StevenKnudsen/tensile-tester-flow/README.md

tensile-tester-flow
===================

Node-Red project for the Hussein Lab Tensile Tester

### About
