StevenKnudsen/tensile-tester-flow/docs/images/dimension-engineering-syren20.png

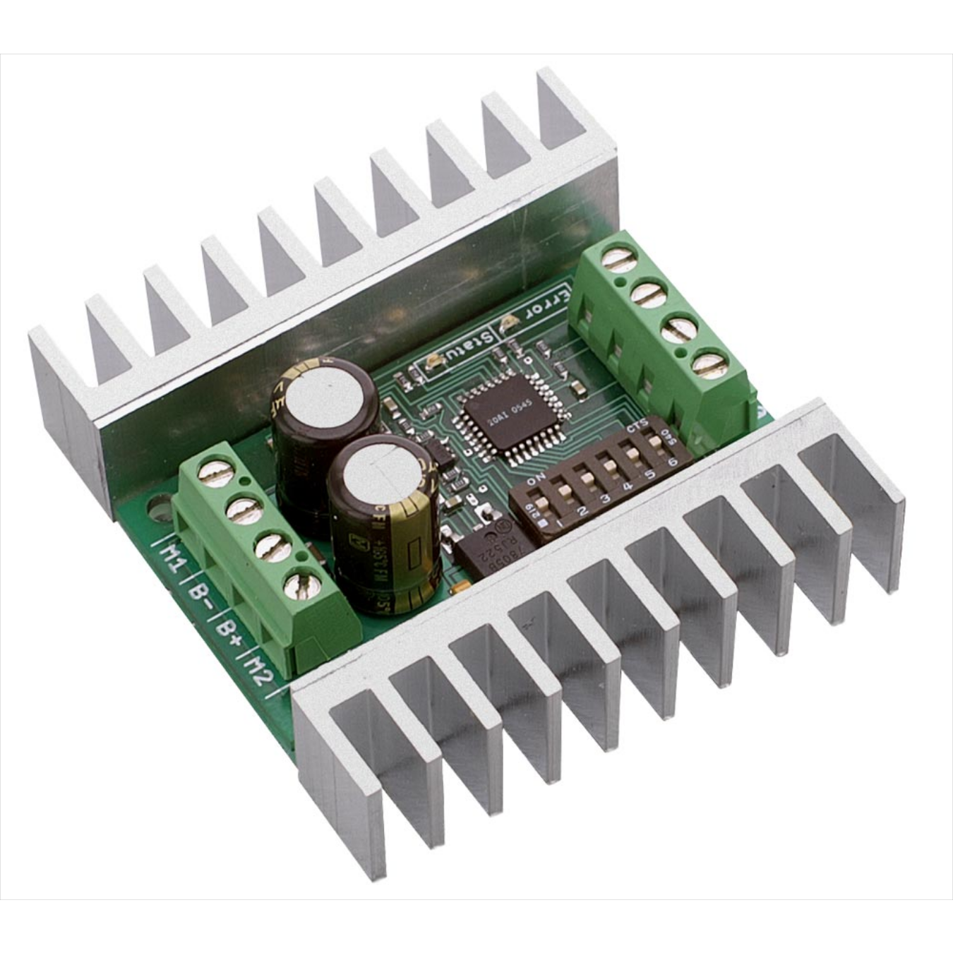
docs/images/dimension-engineering-syren20.png
