StevenKnudsen/tensile-tester-flow/docs/images/HeadStockStepperConnector.png

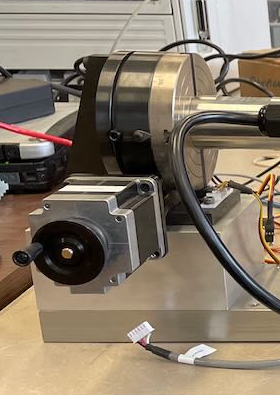
docs/images/HeadStockStepperConnector.png
