StevenKnudsen/tensile-tester-flow/docs/images/ImprovedLinearActuatorAdapter.jpeg

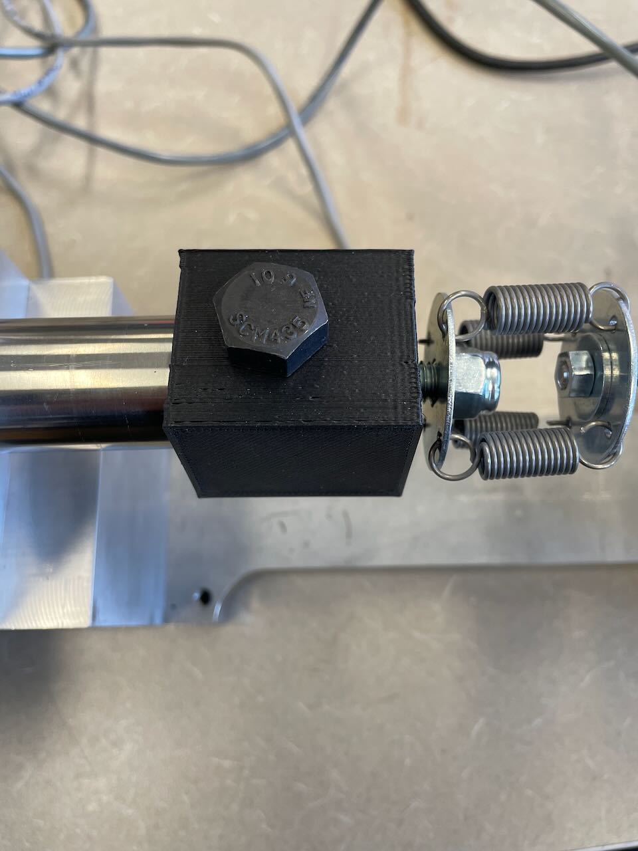
docs/images/ImprovedLinearActuatorAdapter.jpeg
