StevenKnudsen/tensile-tester-flow/docs/images/LinearActuatorConnector.png

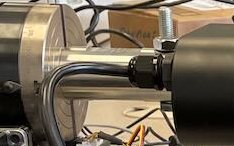
docs/images/LinearActuatorConnector.png
