StevenKnudsen/tensile-tester-flow/docs/images/LinearActuatorDriverConnections01.jpeg

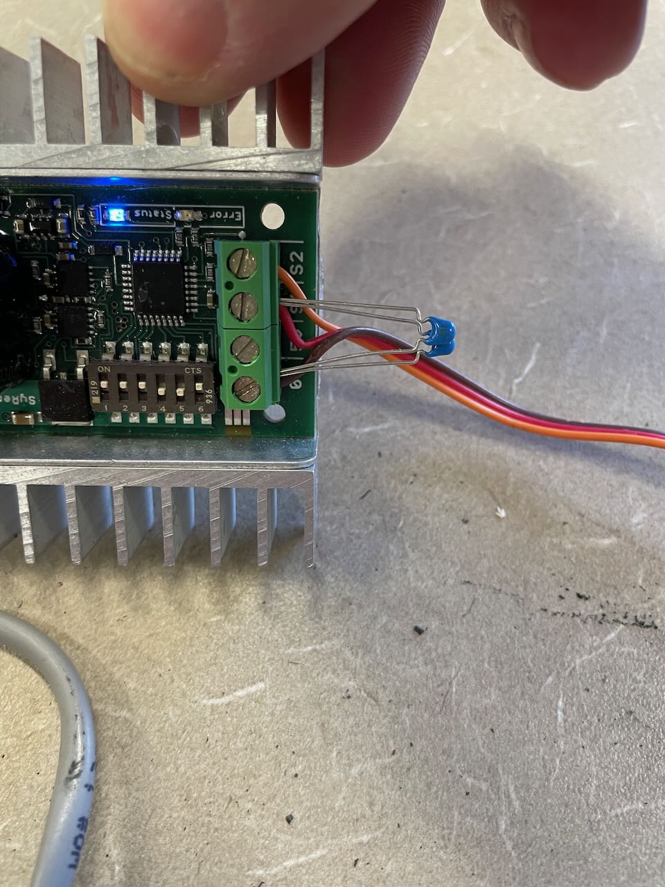
docs/images/LinearActuatorDriverConnections01.jpeg
