StevenKnudsen/tensile-tester-flow/docs/images/LoadCell01.jpg

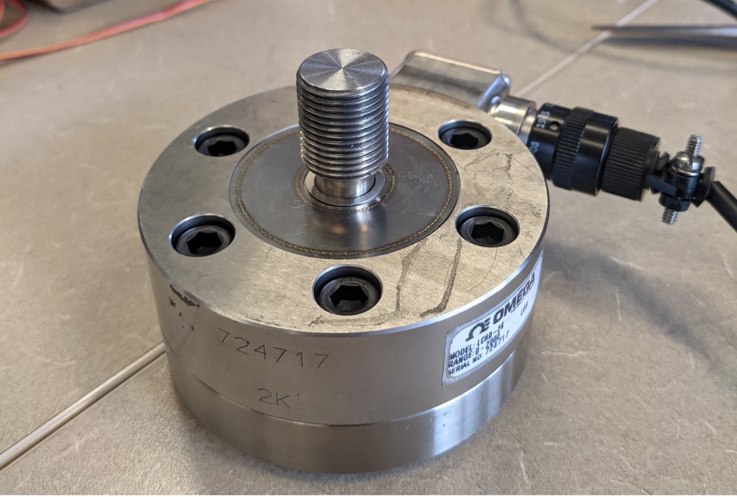
docs/images/LoadCell01.jpg
