StevenKnudsen/tensile-tester-flow/docs/images/LoadCellCal01.jpeg

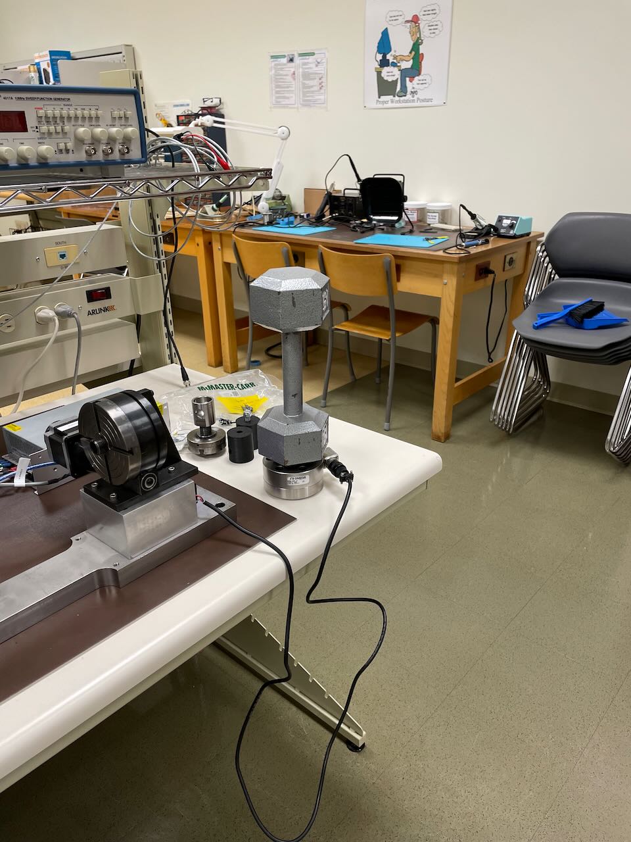
docs/images/LoadCellCal01.jpeg
