StevenKnudsen/tensile-tester-flow/docs/images/OpenScaleBoard.jpeg

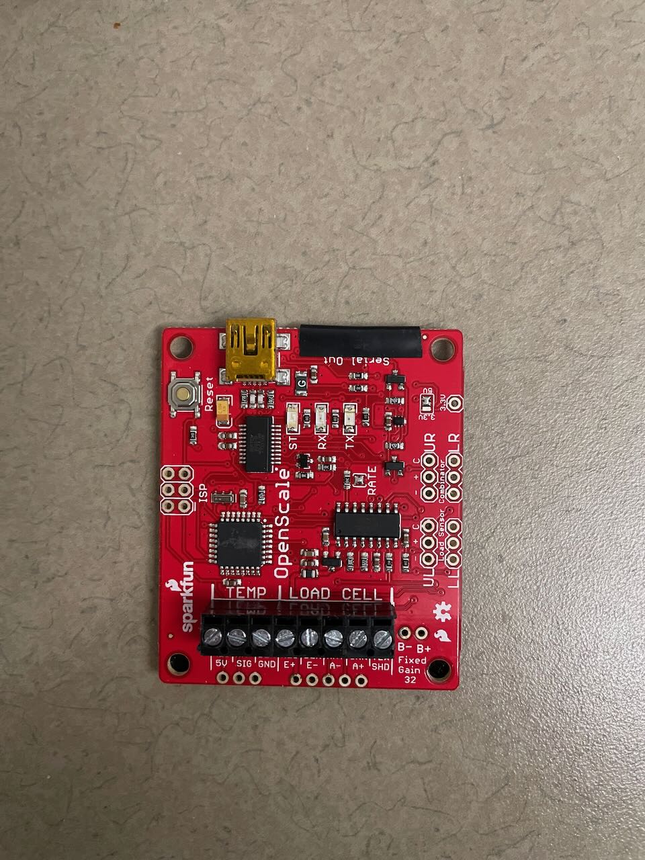
docs/images/OpenScaleBoard.jpeg
