StevenKnudsen/tensile-tester-flow/docs/images/RPI_w_Ribbon.jpeg

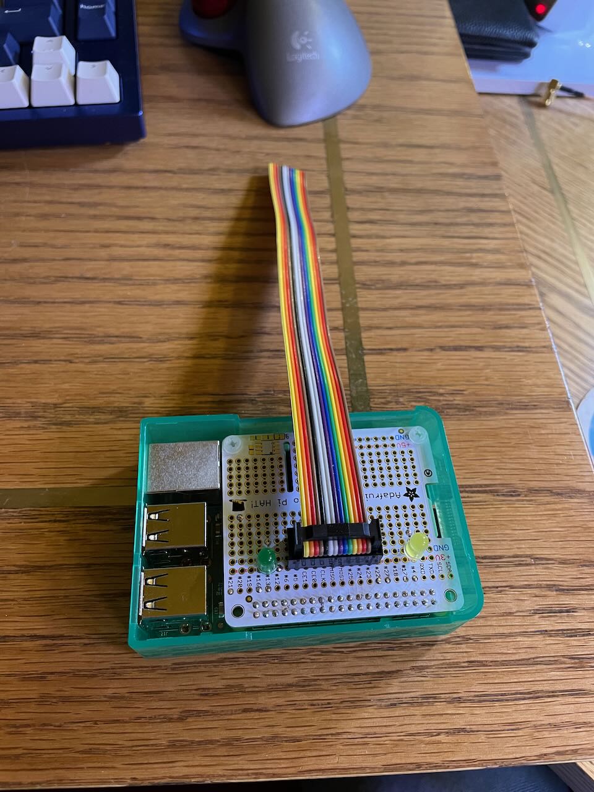
docs/images/RPI_w_Ribbon.jpeg
