StevenKnudsen/tensile-tester-flow/docs/images/SpringConfig01.jpeg

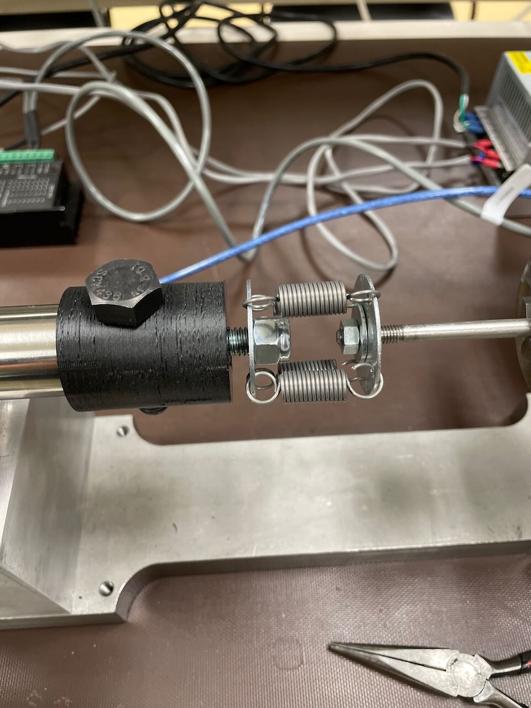
docs/images/SpringConfig01.jpeg
