StevenKnudsen/tensile-tester-flow/docs/images/SpringConfig02.jpeg

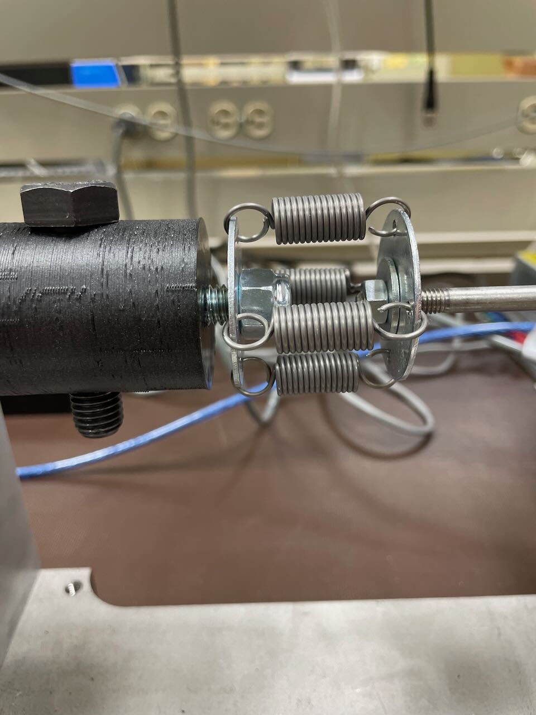
docs/images/SpringConfig02.jpeg
