StevenKnudsen/tensile-tester-flow/docs/images/SpringConfig03.jpeg

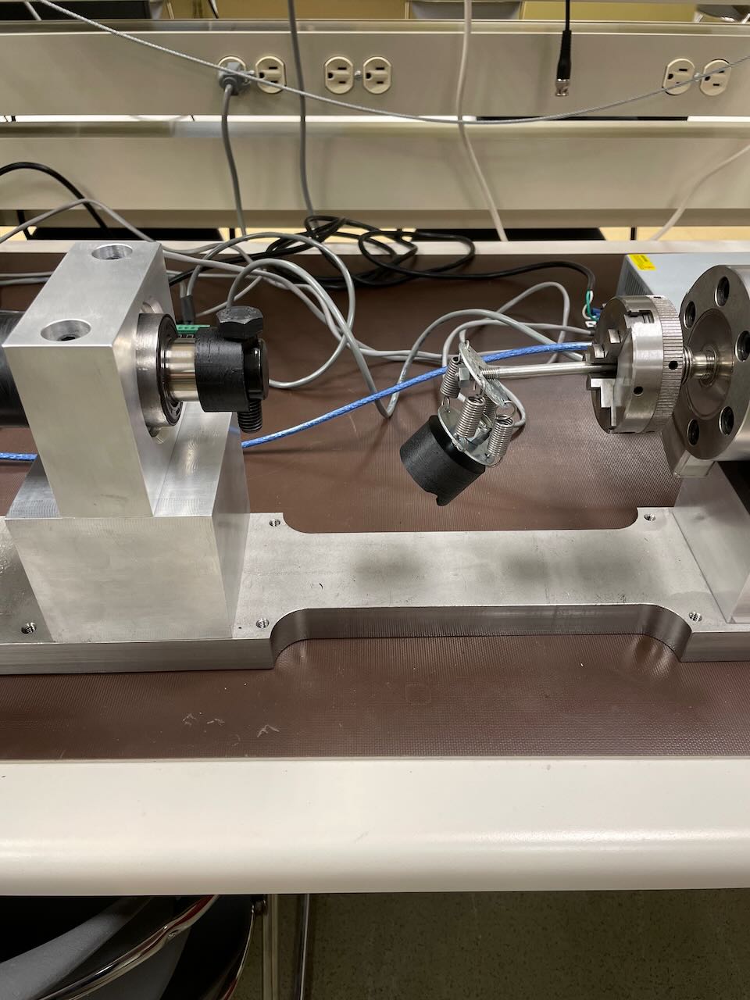
docs/images/SpringConfig03.jpeg
