StevenKnudsen/tensile-tester-flow/docs/images/Startup_Seq.drawio.png

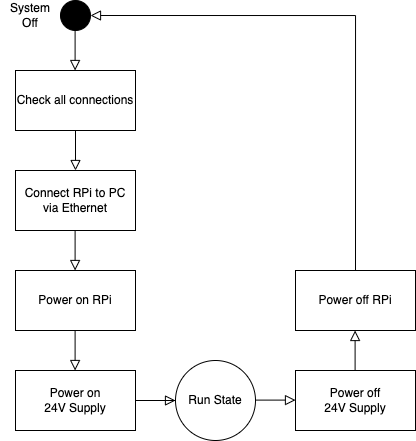
docs/images/Startup_Seq.drawio.png
