StevenKnudsen/tensile-tester-flow/docs/images/StepperDriverConnection01.jpeg

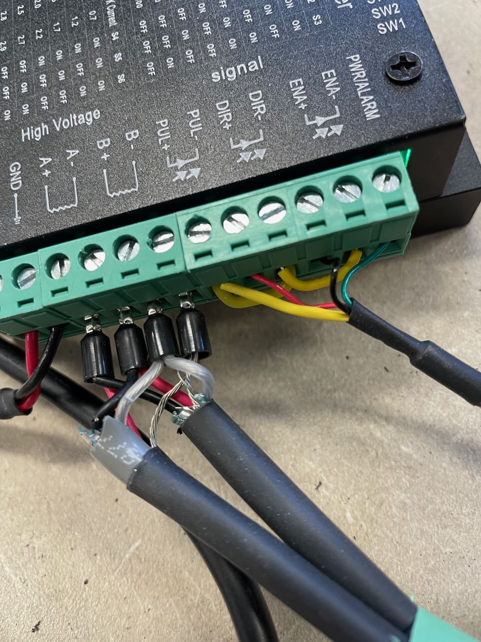
docs/images/StepperDriverConnection01.jpeg
