StevenKnudsen/tensile-tester-flow/docs/images/StepperDriverConnection02.jpeg

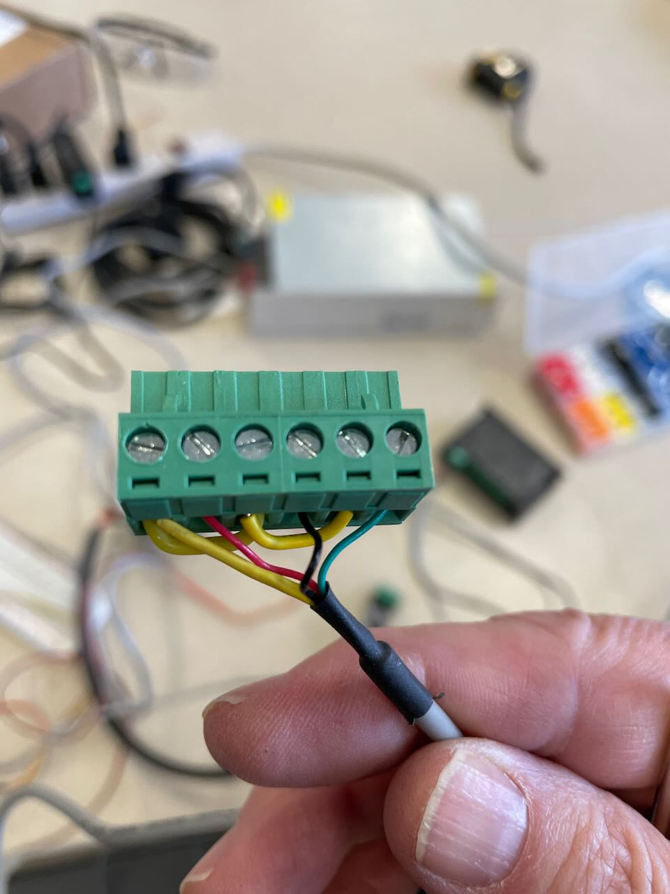
docs/images/StepperDriverConnection02.jpeg
