StevenKnudsen/tensile-tester-flow/docs/images/StepperDriverConnection03.jpeg

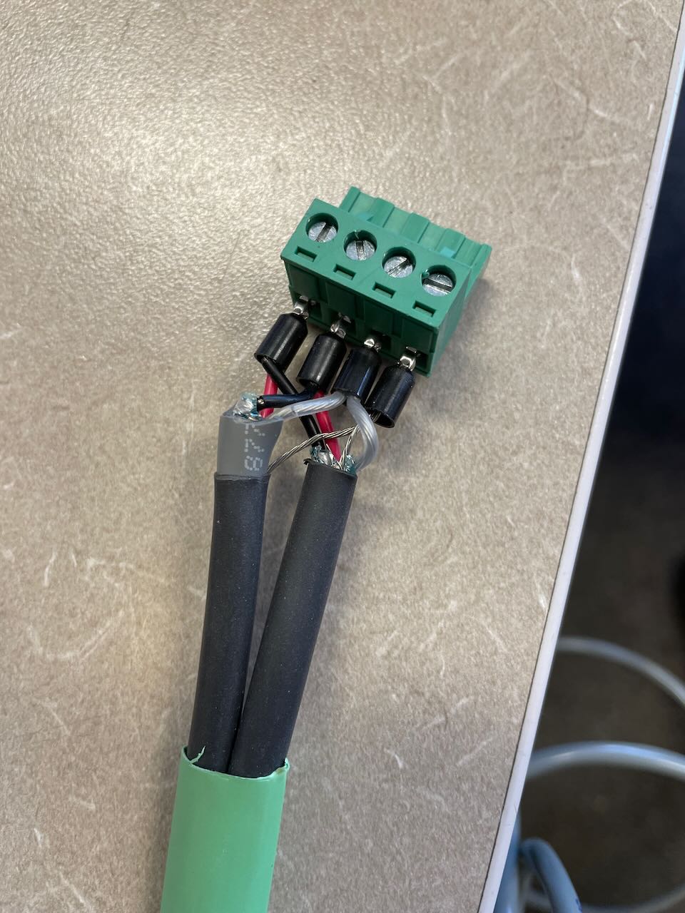
docs/images/StepperDriverConnection03.jpeg
