StevenKnudsen/tensile-tester-flow/docs/images/StopSwitch01.jpg

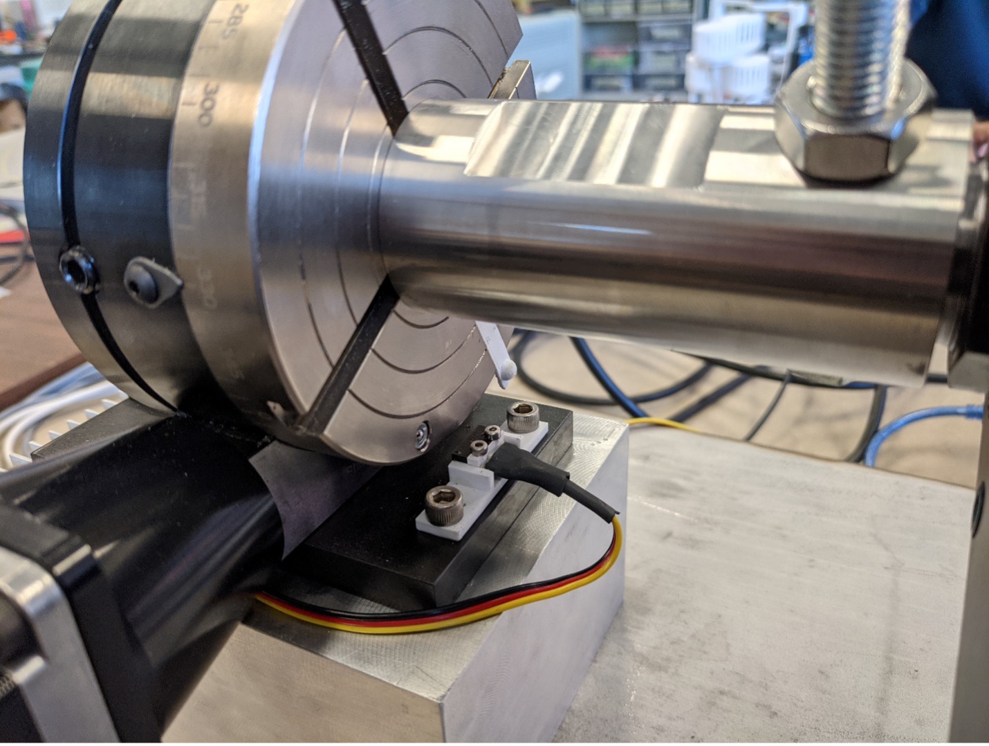
docs/images/StopSwitch01.jpg
