StevenKnudsen/tensile-tester-flow/docs/images/TailStockWithChuck.jpg

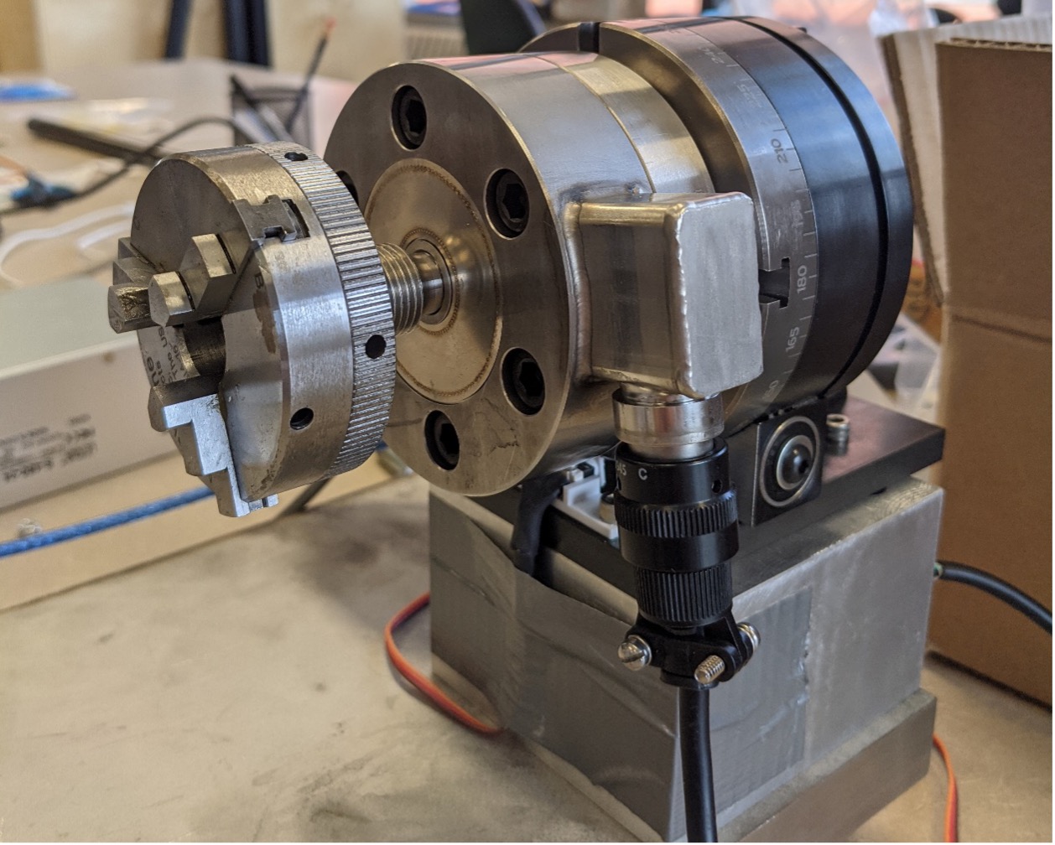
docs/images/TailStockWithChuck.jpg
