StevenKnudsen/tensile-tester-flow/docs/images/tb6600-stepper-motor-driver.jpg

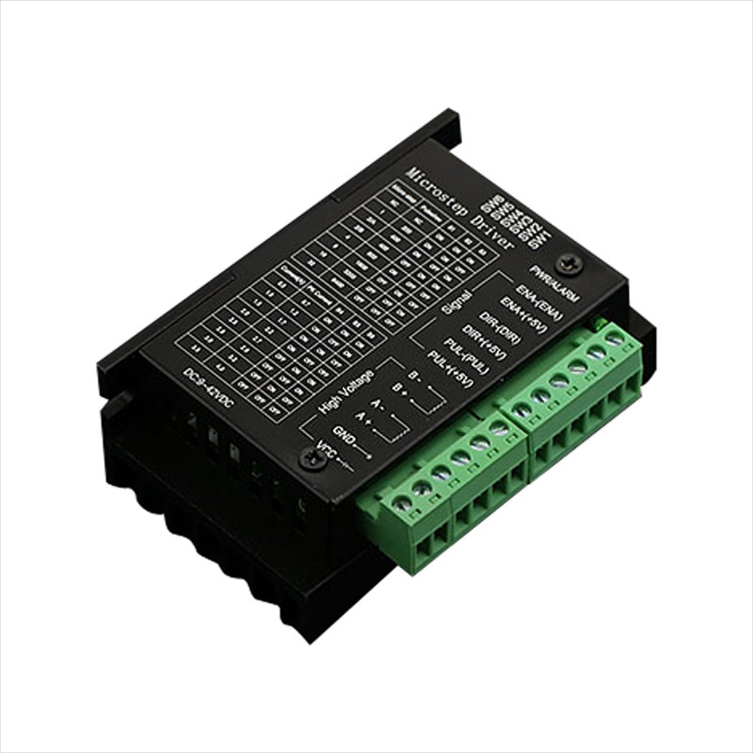
docs/images/tb6600-stepper-motor-driver.jpg
