StevenKnudsen/tensile-tester-flow/docs/images/TTFinalConfig.jpeg

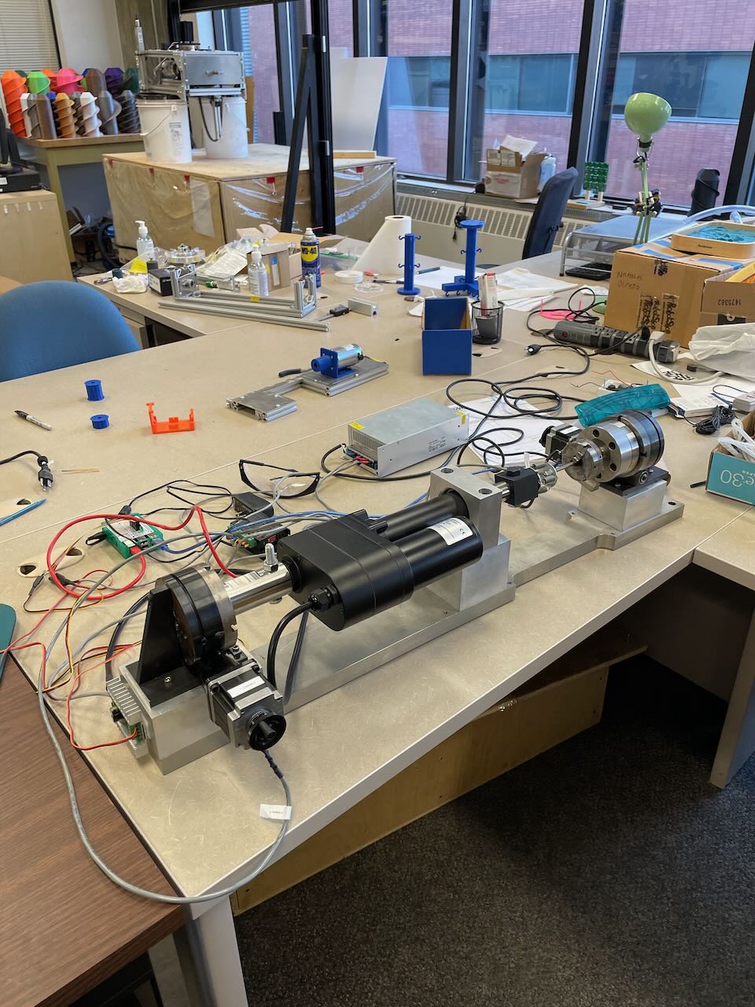
docs/images/TTFinalConfig.jpeg
