StevenKnudsen/tensile-tester-flow/docs/images/TTNoChuckOrGauge.jpeg

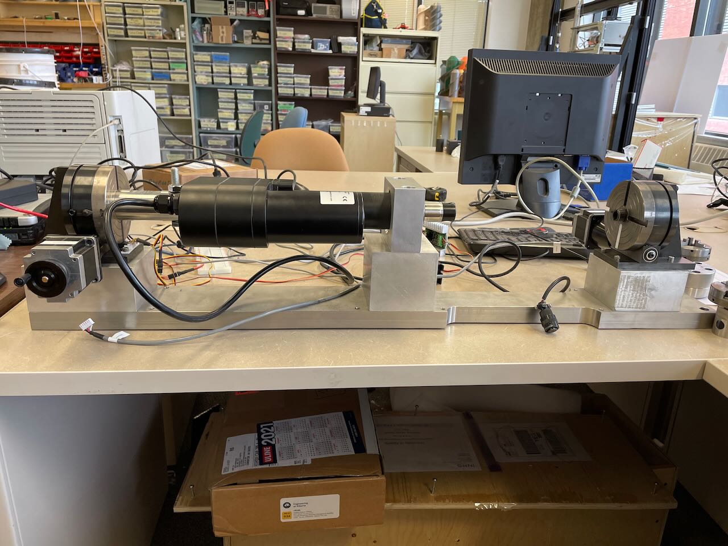
docs/images/TTNoChuckOrGauge.jpeg
