StevenKnudsen/tensile-tester-flow/docs/images/ZeroStop01.jpeg

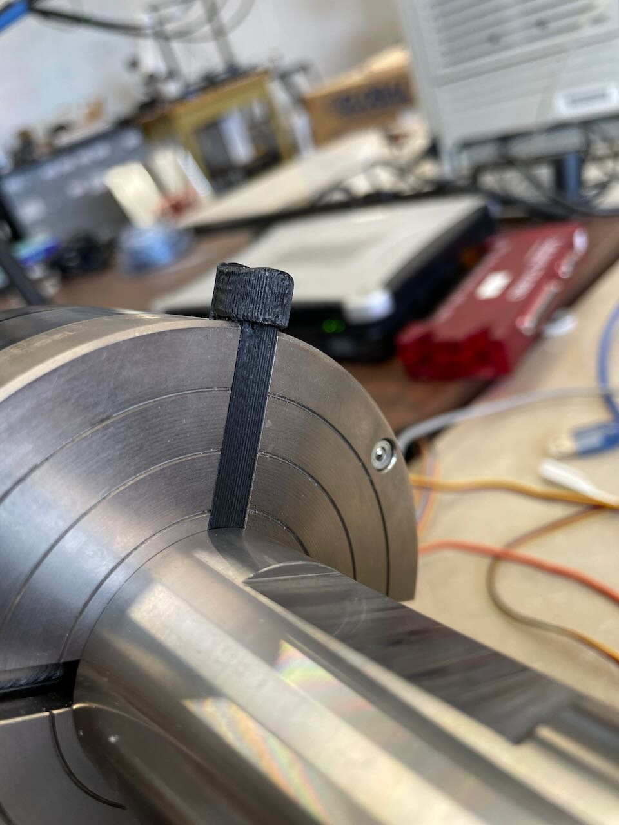
docs/images/ZeroStop01.jpeg
