StevenKnudsen/tensile-tester-flow/docs/images/ZeroStop02.jpeg

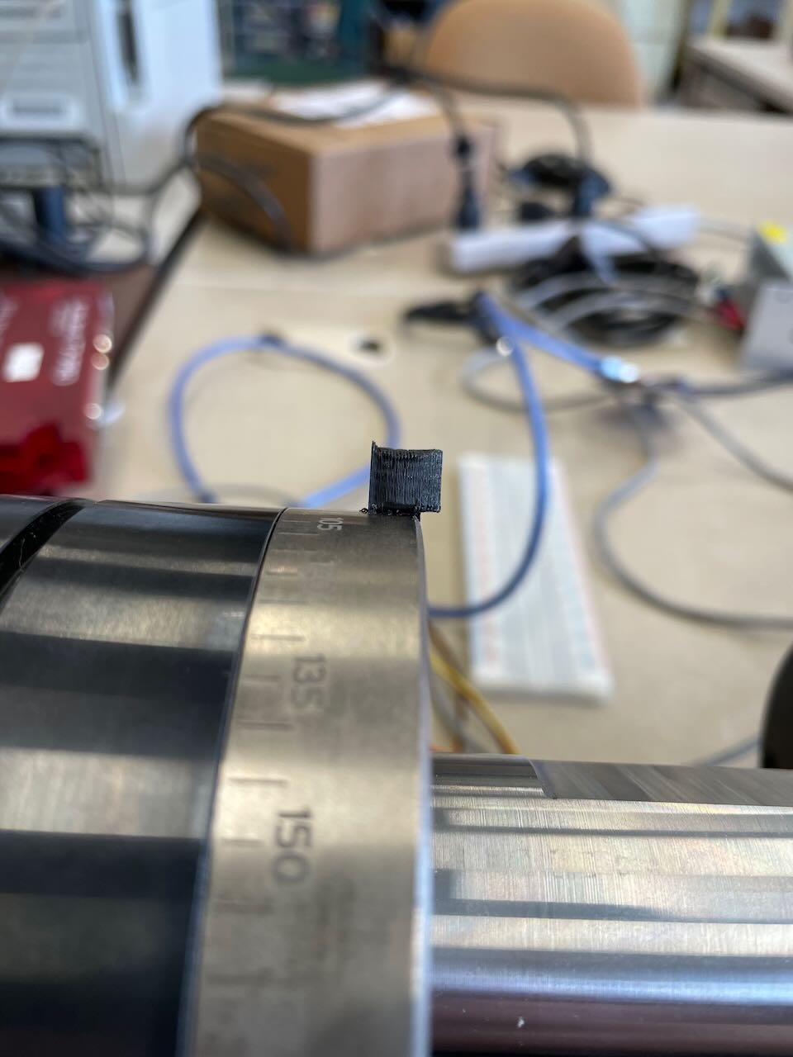
docs/images/ZeroStop02.jpeg
