StevenKnudsen/tensile-tester-flow/mechanical/Zero Position Actuator Design/ZeroPositionActuator.stl

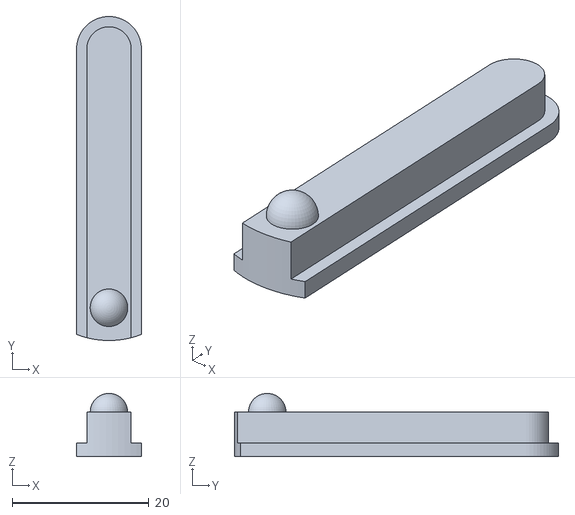
[picture p27: CAD file, 2022-10-16]
mechanical/Zero Position Actuator Design/ZeroPositionActuator.stl
9.50 x 47.4 x 9.25
