StevenKnudsen/tensile-tester-flow/mechanical/Zero Position Actuator Design/ZeroPositionActuatorV.stl

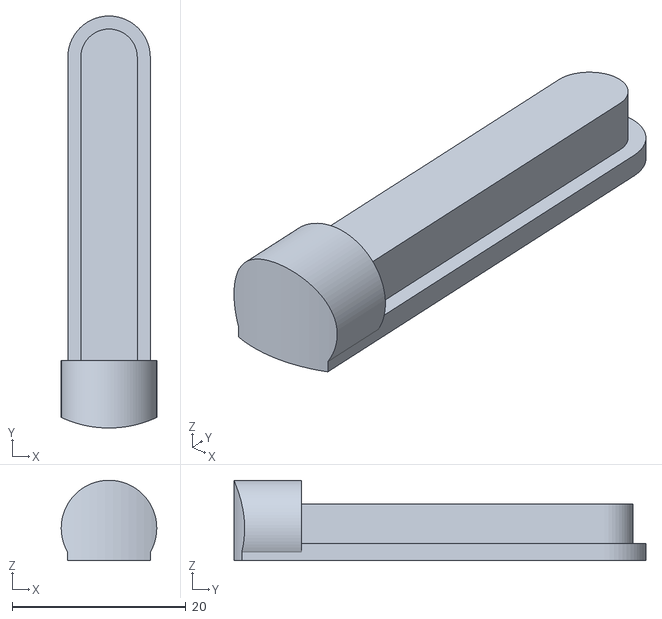
[picture p28: CAD file, 2022-10-16]
mechanical/Zero Position Actuator Design/ZeroPositionActuatorV.stl
11.0 x 47.4 x 9.25
