StevenKnudsen/tensile-tester-flow/mechanical/LinearActuatorAdapters/SpringMountActuatorCap_Carriage.stl

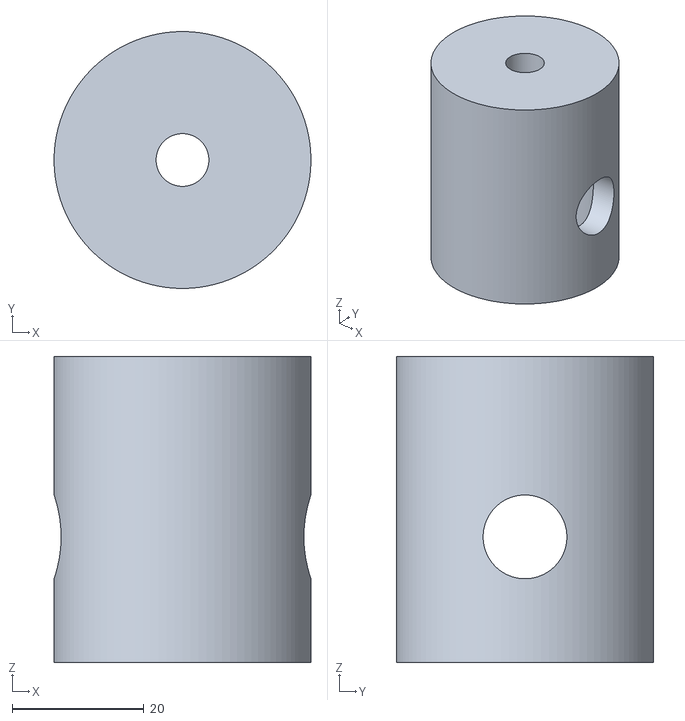
[picture p29: CAD file, 2022-10-14]
mechanical/LinearActuatorAdapters/SpringMountActuatorCap_Carriage.stl
39.0 x 39.0 x 46.4
