StevenKnudsen/tensile-tester-flow/mechanical/LinearActuatorAdapters/SpringMountActuatorCap_BoltCube.stl

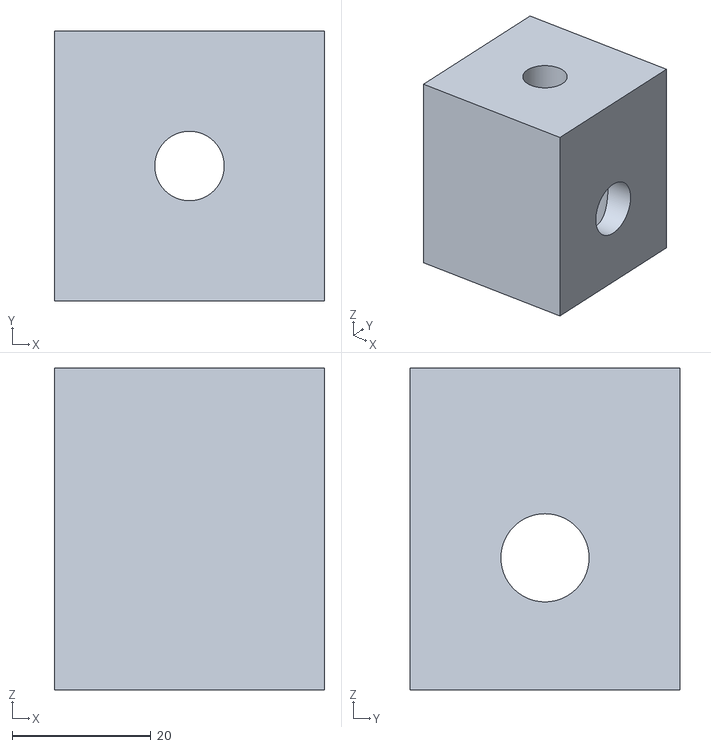
[picture p30: CAD file, 2022-10-14]
mechanical/LinearActuatorAdapters/SpringMountActuatorCap_BoltCube.stl
39.0 x 39.0 x 46.4
