StevenKnudsen/tensile-tester-flow/mechanical/archive/ZeroStop/switch v6 v1.stl

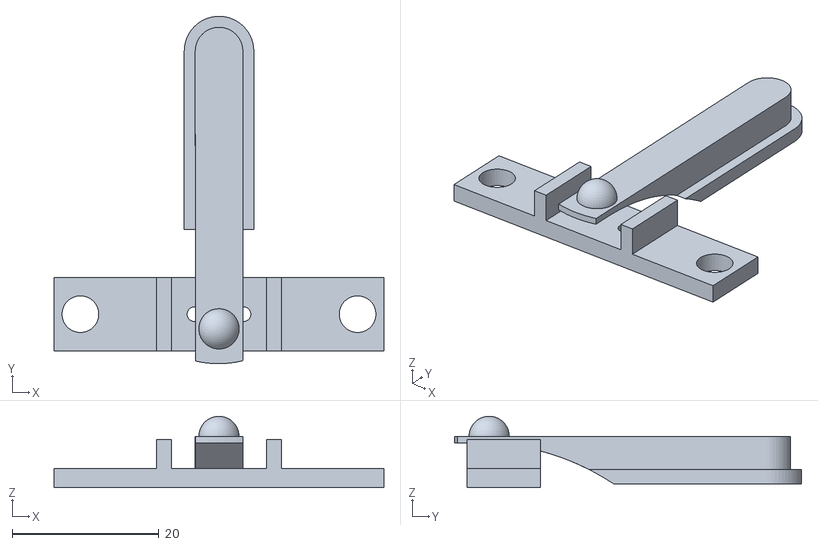
[picture p31: CAD file, 2022-10-16, an earlier design]
mechanical/archive/ZeroStop/switch v6 v1.stl
45.0 x 47.4 x 9.75
