StevenKnudsen/tensile-tester-flow/mechanical/archive/ZeroStop/switch v6 v1a.stl

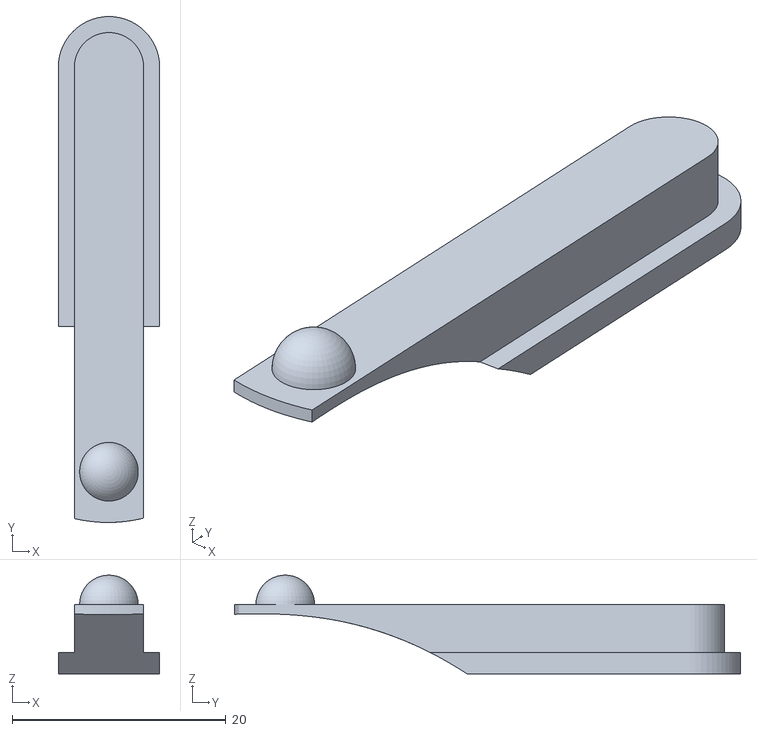
[picture p32: CAD file, 2022-10-16, an earlier design]
mechanical/archive/ZeroStop/switch v6 v1a.stl
9.50 x 47.4 x 9.25
