StevenKnudsen/tensile-tester-flow/mechanical/archive/ZeroStop/mount.stl

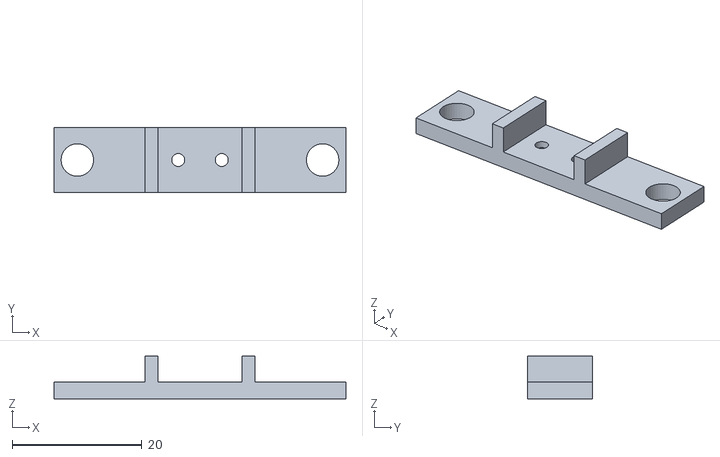
[picture p33: CAD file, 2022-10-14, an earlier design]
mechanical/archive/ZeroStop/mount.stl
45.0 x 10.0 x 6.60
