StevenKnudsen/tensile-tester-flow/(list of files, cad)

Other CAD files:
mechanical/LinearActuatorAdapters/SpringMountActuatorCap_Bolt.stl
mechanical/archive/ZeroStop/switch v6.step
mechanical/archive/ZeroStop/springswitch.stl
mechanical/LinearActuatorAdapters/SpringMountActuatorCap_BoltCube.scad
mechanical/LinearActuatorAdapters/SpringMountActuatorCap_Carriage.scad
mechanical/Zero Position Actuator Design/ZeroPositionActuatorV.scad
