StevenKnudsen/tensile-tester-flow/docs/TensileTester RPi Setup.pdf

# Setting up Raspberry Pi for Tensile Tester operation

OS version : raspios bullseye

Follow the usual steps (https://www.raspberrypi.com/software/) to create a RPi image and boot

It is easiest to use the dedicated application, Raspberry Pi Imager, that creates the SD card for your RPi
Choose to customize the installed image
Set the hostname to tensilepi
Set the username to tensile and the password to t3ns1le
You can try to set the wireless nework to UWS and your password, but usually this doesn't work because UWS is, well, UWS
Set the wireless LAN country to CA
Set the locale to Edmonton and leave the keyboard a US
Change to the Services section and enable SSH. Select "Use password authentication"
Save and say yes to using the custom settings, then yes to start formating the image

When the Imager is finished, pop the SD card into the RPi and boot

The very first boot will take some time as the OS configures itself.

Connect to Wifi

It appears that UWS at the UofA will not work
An option is to tether to a cellphone, which does work well.

Update the system via the terminal; sudo apt update , then sudo apt upgrade

This may take a while

Enable VNC

sudo raspi-config
Navigate to Interface Option and hit enter Navigate to VNC and hit enter
Set the VNC server to be yes, hit enter exit raspi-config

reboot

Test the VNC connection using your laptop

On a Mac, install tigervnc-viewer , for example Get the RPi IP address
Connect using the VNC viewer

Install and configure node-red using this guide (https://nodered.org/docs/getting-started/raspberrypi)

Execute in a terminal the following

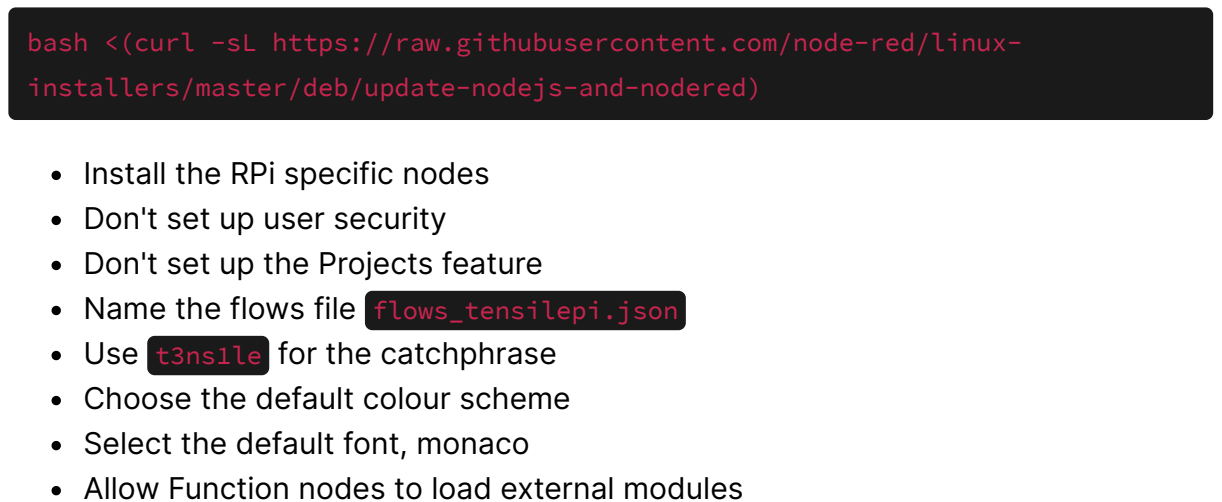
[picture p34: figure]
bash <(curl -sL https://raw.githubusercontent.com/node-red/linux- installers/master/deb/update-nodejs-and-nodered); Install the RPi specific nodes Don't set up user security Don't set up the Projects feature Name the flows file flows_tensilepi.json Use t3ns1le for the catchphrase Choose the default colour scheme Select the default font, monaco

Allow Function nodes to load external modules Enable node-red to start at boot

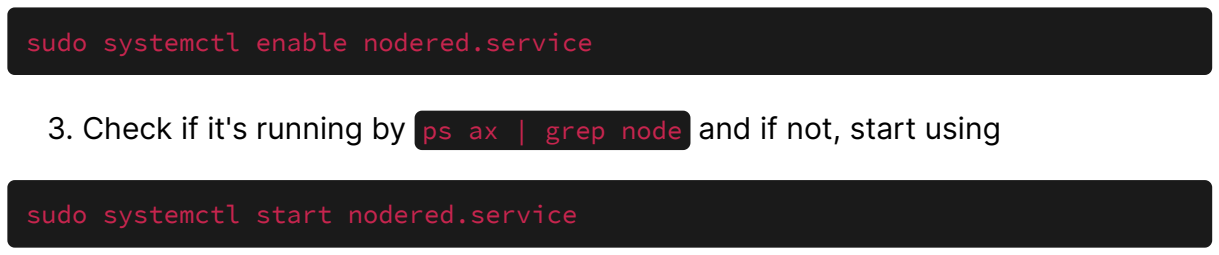
[picture p35: figure]
sudo systemctl enable nodered.service; sudo systemctl start nodered.service

Check if it's running by ps ax | grep node and if not, start using

Now you can bring up the node-red flow editor on a computer on the same network as the tensilepi by connecting to http://tensilepi.local:1880 in a browser

Install the node-red dashboard and git packages

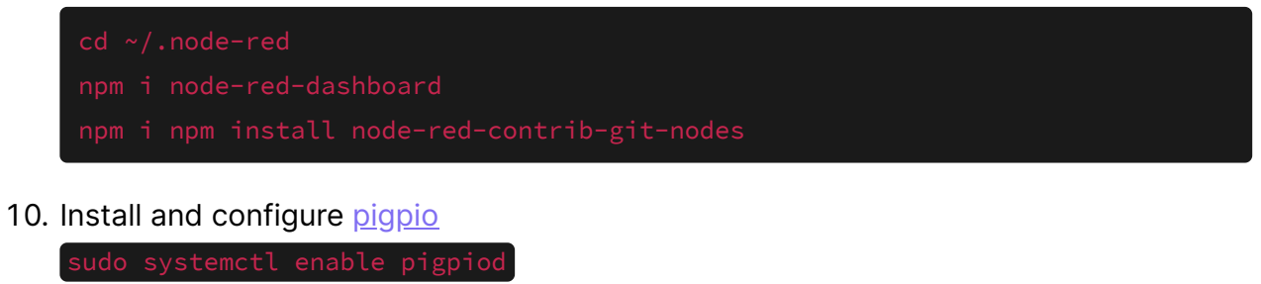
[picture p36: figure]
cd ~/.node-red npm i node-red-dashboard npm i npm install node-red-contrib-git-nodes; Install and configure pigpio; sudo systemctl enable pigpiod

Restart node-red on the RPi

node-red-restart

Once restarted, you can bring up the node-red dashboard on a computer on the same network as the tensilepi by connecting to http://tensilepi.local:1880/ui in a browser.

changes made in the flow editor will be reflected in the UI once they are "deployed"

The flow editor can be accessed by connecting to http://tensilepi.local:1880

We need a couple of contributed nodes. They are installed from the node-red root directory, so cd ~/.node-red

Install the PID node; npm install node-red-contrib-pid

Install the UI List node; npm install node-red-node-ui-list

Restart node-red; node-red-restart

Now, PID will show up under the function group and list under the dashboard group

The next thing to do is import the flows_tensilepi.json file to get back all our control UI and algorithms.

Using the "stacked" aka "hamburger" menu at the top right, choose Import.

Select the flows_tensilepi.json file from the repo and import.

The Flow should appear as a tab.

Deploy it and check that the UI is now there.

Last, build the C modules

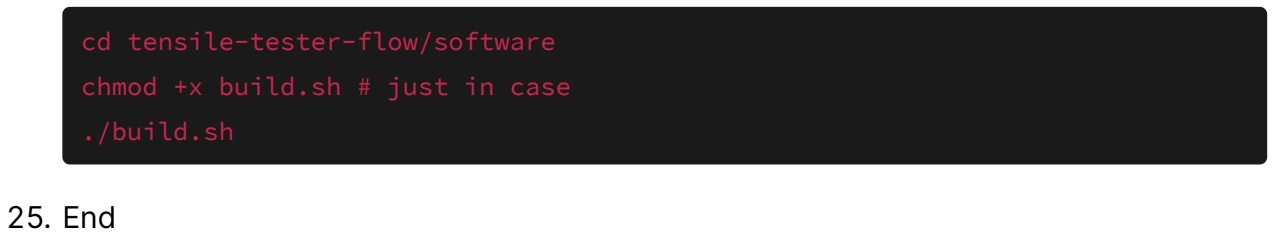
[picture p37: figure]
cd tensile-tester-flow/software chmod +x build.sh # just in case ./build.sh; End
