StevenKnudsen/tensile-tester-flow/docs/Tensile Tester Build and Operate.md

# HOWTO build and operate the tensile tester

## Source and Documentation
https://github.com/StevenKnudsen/tensile-tester.git

## Hardware connections

## Operations
