StevenKnudsen/tensile-tester-flow/docs/images/TailStockDisassembled.png

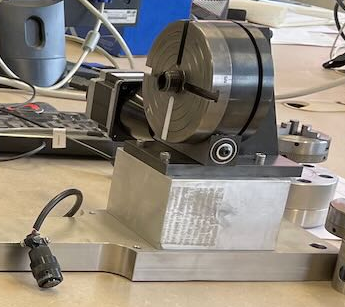
docs/images/TailStockDisassembled.png
