StevenKnudsen/tensile-tester-flow/docs/images/LoadCellCalibrate01.jpg

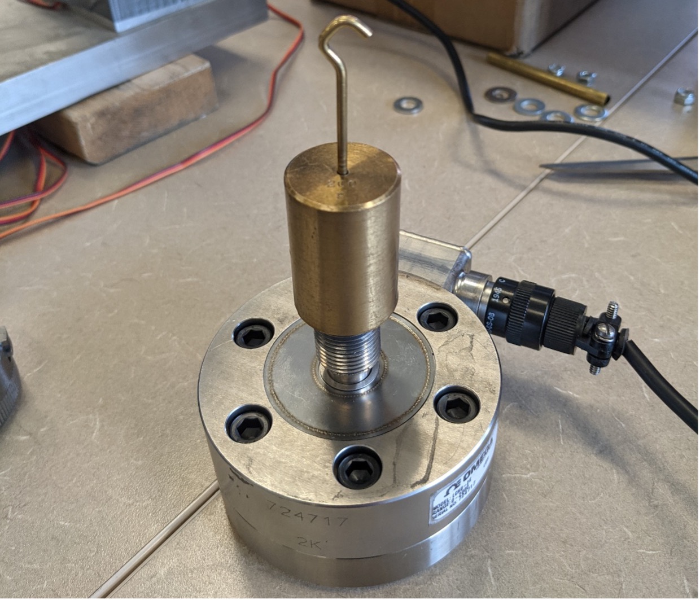
docs/images/LoadCellCalibrate01.jpg
