StevenKnudsen/tensile-tester-flow/docs/images/TensileTesterBlockDiagram.drawio.png

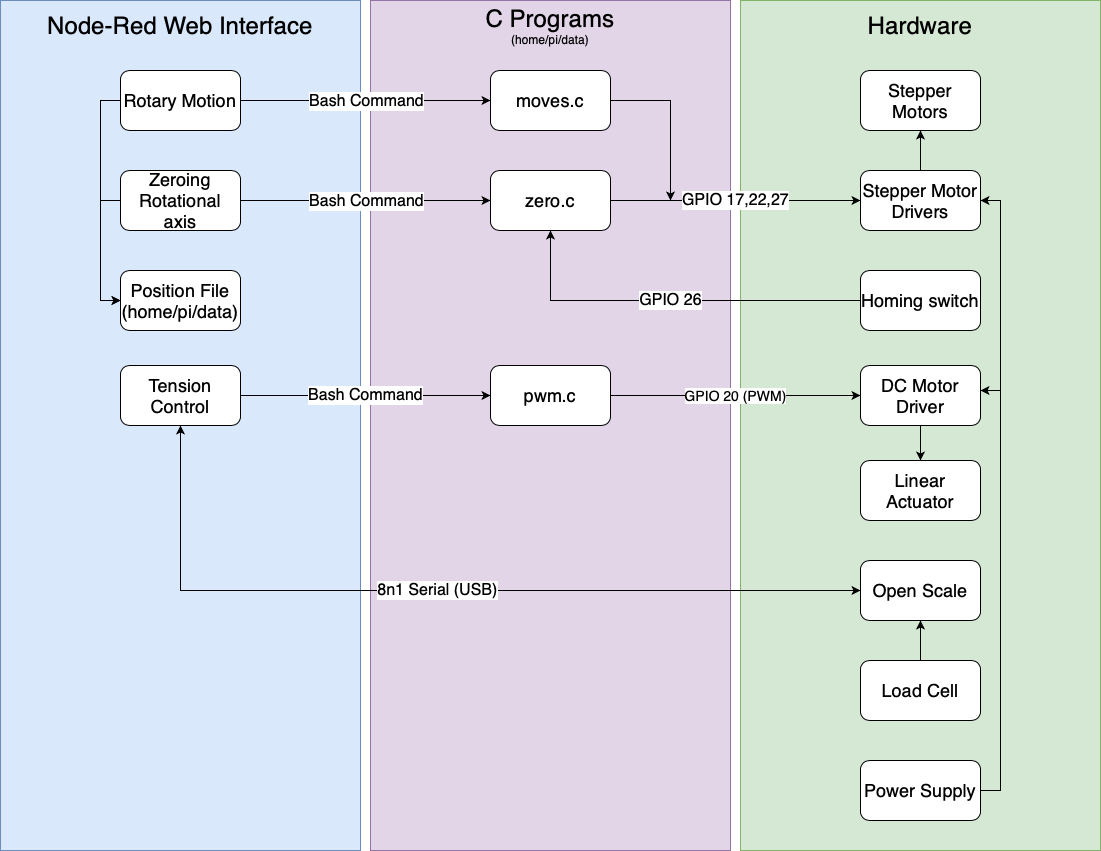
docs/images/TensileTesterBlockDiagram.drawio.png
