StevenKnudsen/tensile-tester-flow/(commit log)

2022-06-12 many changes to improve UI, tighten code. About ready for PID tuning, but actuator seems to have sticktion aka no response to low duty cycle, so can't do much except on-off setting
2022-10-14 major documentation update
    [SpringMountActuatorCap_Bolt.scad, SpringMountActuatorCap_Bolt.stl, SpringMountActuatorCap_BoltCube.scad, SpringMountActuatorCap_BoltCube.stl, SpringMountActuatorCap_Carriage.scad, SpringMountActuatorCap_Carriage.stl, mount.stl, springswitch.stl]
2022-10-16 Design for 3D printed actuator that activates the zero switch.
    The OpenSCAD file can be used to modify this designs. The STLs match the implementation as of summer 2022. The Simplify3D factory file it probably not that useful to anyone but KSK.
    [ZeroPositionActuator.scad, ZeroPositionActuator.stl, ZeroPositionActuatorV.scad, ZeroPositionActuatorV.stl]
2022-10-16 Add legacy design files for zero switch
    [switch v6 v1.stl, switch v6 v1a.stl, switch v6.step]
